RollMan/audiomixer_kansa/README.md

## 改善点
- schematic のカップリングコンデンサに極性がなく、PCB のシルクが示すコンデンサのピンアサインが反転している。
- 入出力の 3.5mm フォーンジャックが基板の中程にあるせいで、一部のフォーンジャック、特にハンドル (先端接触部の次にある絶縁体部) が太いジャックが刺さらない。
- 積層セラミックコンデンサのピンピッチ (足幅) が BOM のものと合わない。
- C9, C10 のピンピッチ (足幅) が BOM のものと合わない。
