RollMan/audiomixer_kansa/kicad/mixeramp/mixeramp.kicad_pcb

## KiCad design kicad/mixeramp/mixeramp.kicad_pcb (2024-07-31)

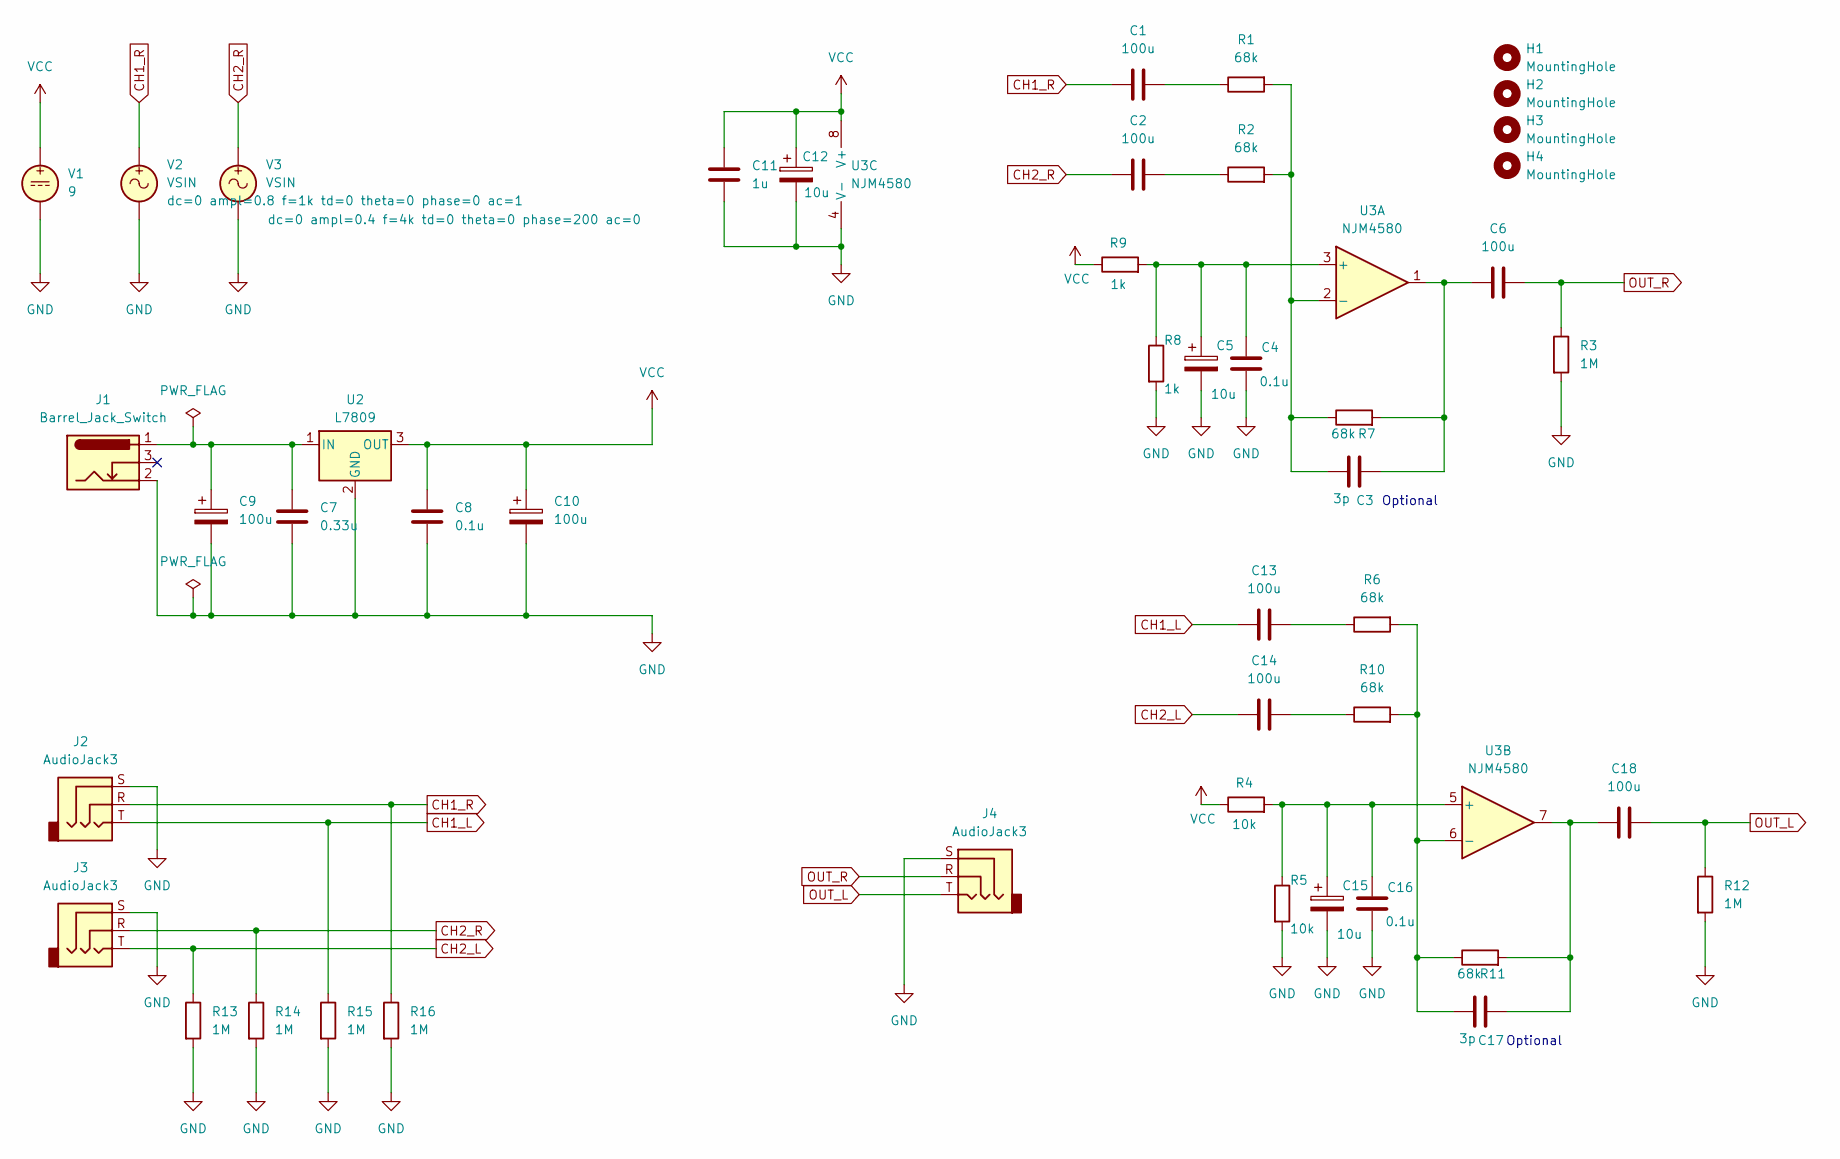
[picture p1: schematic mixeramp.kicad_sch]

Parts:
C1, C2, C6, C13, C14, C18: 100u; CP_Radial_D8.0mm_P3.50mm
C3, C17: 3p; C_Disc_D3.8mm_W2.6mm_P2.50mm
C4, C8, C16: 0.1u; C_Disc_D3.8mm_W2.6mm_P2.50mm
C5, C12, C15: 10u; C_Disc_D3.8mm_W2.6mm_P2.50mm; MPN RD20F106Z1EH5L
C7: 0.33u; C_Disc_D3.8mm_W2.6mm_P2.50mm; MPN RD15W334K1HL2L
C9, C10: 100u; CP_Radial_D5.0mm_P2.50mm
C11: 1u; C_Disc_D3.8mm_W2.6mm_P2.50mm
H1, H2, H3, H4: MountingHole; MountingHole_3.2mm_M3
J1: Barrel_Jack_Switch; BarrelJack_Horizontal
J2, J3, J4: AudioJack3; Jack_3.5mm_Switronic_ST-005-G_horizontal; MPN ST-005-G
R1, R2, R6, R10: 68k; R_Axial_DIN0411_L9.9mm_D3.6mm_P15.24mm_Horizontal
R3, R12, R13, R14, R15, R16: 1M; R_Axial_DIN0411_L9.9mm_D3.6mm_P15.24mm_Horizontal
R4, R5: 10k; R_Axial_DIN0411_L9.9mm_D3.6mm_P15.24mm_Horizontal
R7, R11: 68k; R_Axial_DIN0204_L3.6mm_D1.6mm_P2.54mm_Vertical
R8, R9: 1k; R_Axial_DIN0411_L9.9mm_D3.6mm_P15.24mm_Horizontal
U2: L7809; TO-220-3_Vertical; MPN L7809CV
U3: NJM4580; DIP-8_W7.62mm
V1: 9
V2, V3: VSIN

Connections:
CH1_L: C13.1, J2.T, R15.1
CH1_R: C1.1, J2.R, R16.1, V2.1
CH2_L: C14.1, J3.T, R13.1
CH2_R: C2.1, J3.R, R14.1, V3.1
GND: C4.2, C5.2, C7.2, C8.2, C9.2, C10.2, C11.2, C12.2, C15.2, C16.2, J1.2, J2.S, J3.S, J4.S, R3.2, R5.2, R8.2, R12.2, R13.2, R14.2, R15.2, R16.2, U2.2 (GND), U3.4 (V-), V1.2, V2.2, V3.2
unnamed: C1.2, R1.1
unnamed: C2.2, R2.1
unnamed: C3.2, C6.1, R7.2, U3.1
unnamed: C13.2, R6.1
unnamed: C14.2, R10.1
unnamed: C17.2, C18.1, R11.2, U3.7
unnamed: C7.1, C9.1, J1.1, U2.1 (IN)
unnamed: C4.1, C5.1, R8.1, R9.2, U3.3 (+)
unnamed: C3.1, R1.2, R2.2, R7.1, U3.2 (-)
unnamed: C15.1, C16.1, R4.2, R5.1, U3.5 (+)
unnamed: C17.1, R6.2, R10.2, R11.1, U3.6 (-)
OUT_L: C18.2, J4.T, R12.1
OUT_R: C6.2, J4.R, R3.1
VCC: C8.1, C10.1, C11.1, C12.1, R4.1, R9.1, U2.3 (OUT), U3.8 (V+), V1.1

Notes on the sheet:
Optional

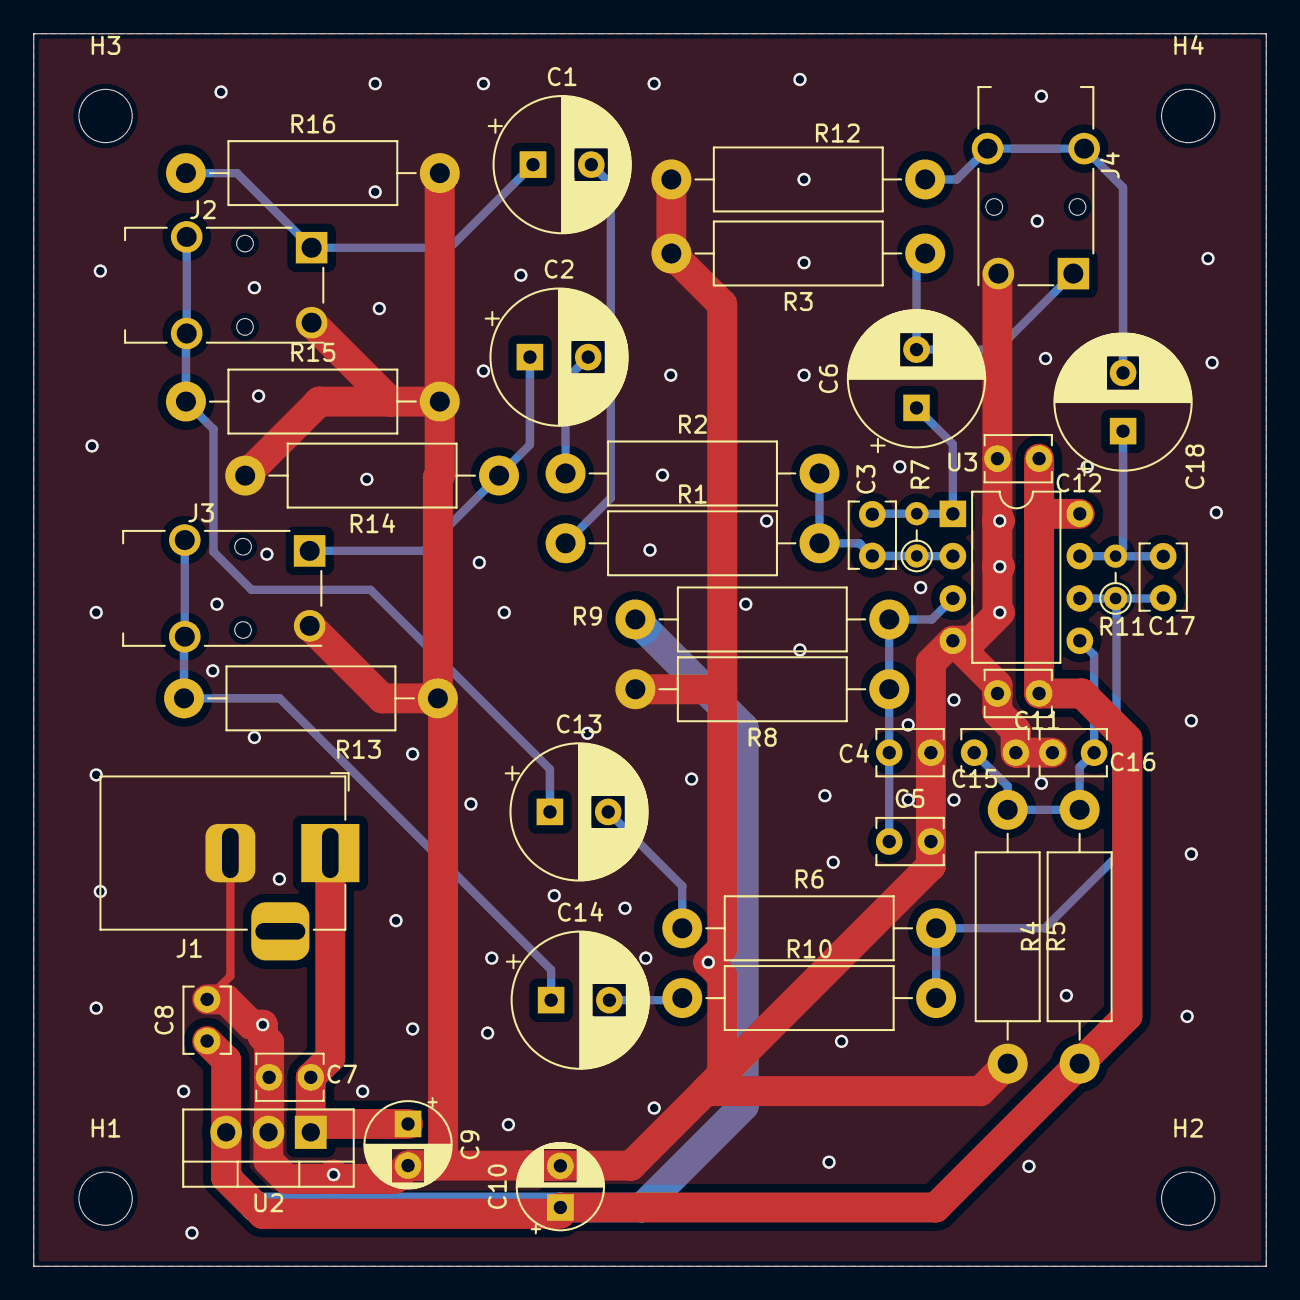
[picture p2: board mixeramp.kicad_pcb from above]

Board: 2 copper layers, 74.0 x 74.0 mm, 44 parts (0 on the bottom side), 19 nets.
