RollMan/audiomixer_kansa/(commit log)

2024-05-26 simulation with buffers at input
    [mixeramp.kicad_pcb, mixeramp.kicad_sch]
2024-05-26 remove buffer
    [mixeramp.kicad_sch]
2024-07-29 wip: making BOM and footprint list
    [mixeramp.kicad_sch]
2024-07-29 make BOM and footprint list
    [mixeramp.kicad_sch]
2024-07-30 place footprints
    [mixeramp.kicad_pcb, mixeramp.kicad_sch]
2024-07-30 add pcb
    [mixeramp.kicad_pcb]
2024-07-30 change via size constraints
    [mixeramp.kicad_pcb]
2024-07-31 adjust silkscreen placements
    [mixeramp.kicad_pcb]
2024-07-31 export gerbers for jlcpcb
    [mixeramp.kicad_pcb]
2024-07-31 add MPNs for several components
    [mixeramp.kicad_sch]
